CircuitCo/BeagleBone-LCD4-RevA1/README

The BeagleBone LCD4 Cape provides a portable LCD solution with touchscreen capability for BeagleBone boards. The 4.3" TFT LCD screen, attached to the topside of the board, can display up to a resolution of 480x272 and is a 4-wire resistive touchscreen. The board is equipped with seven buttons located at finger-friendly positions. These buttons include power, reset, and five user buttons, which are mapped to different GPIO signals. The backside of the cape is where a BeagleBone can be mounted.
