CircuitCo/BeagleBone-LCD4-RevA1/BeagleBone-LCD4-RevA1-bom.xls

BeagleBone LCD4 Cape COVER PAGE Revised: Wednsday, November 28, 2012
BB-BONE-LCD4-01 Revision: A1
ITM | QTY | REF DESIGNATIORS | PART | Foot Print | DESCRIPTION | MAN | PART # | COMMENT
1 | 1 | PCB |  |  |  |  | BB-BONE-LCD4-PCB-02
 | 20 | C1,C2,C3,C4,C5,C6,C7,C8,C9,C10,C11,C12,C13,C14,C15,C16,C17,C18,C19,C23 | 0.1uF | 402 | Capacitor 0.1uF 16V 10% 0402 X7R | Kemet | C0402C104K4RACT
2 | 2 | C20,C21 | 10uF,10V | 805 | CAP CER 10UF 10V Y5V 0805 | TDK | C2012Y5V1A106Z
3 | 2 | C38,C40 | 4.7uF, 25V | c805-35x60 | CAP CER 4.7UF 50V X5R 10% 0805 |  | C2012X5R1H475K
4 | 1 | C39 | 47nF | c402-25 | CAP CER 0.047UF 25V X5R 0402 |  | TMK105B7473KV-F
5 | 2 | D4,D5 | LTST-C190GKT | led2-31sq | LED GREEN CLEAR 0603 SMD |  | LTST-C190GKT
6 | 1 | L2 | 4.7uH | ind-lqh32m | INDUCTOR 4.7UH 20% 450MA 1210 |  | LQH32CN4R7M23L
7 | 2 | P1,P2 | MALE HEADER 2x23 | HEADER23X2 |  | MLE | BSTS-123-D-A-16-F-300-LF
8 | 1 | P5 |  | CON40SMD_P5MMLS_HRS_FH19SC | CONN FPC/FFC 40POS .5MM SMD GOLD | HIROSE | FH19C-40S-0.5SH(05)
9 | 1 | Q1 | DMC56404 | SMini6-F3-B | TRANS PREBIASED DUAL NPN SOT363 |  | DDC114YU-7-F
10 | 1 | Q3 | BSS138 | SOT23-3 | MOSFET Nchan 50V 200mA | Diodes Inc. | BSS138-7-F
11 | 2 | R3,R4 | 5.6K | 402 | RES 5.6K OHM 1/16W 5% 0402 SMD | Yaego | RC0402JR-075K6L
12 | 3 | R5,R6,R7 | 4.75K | 402 | RES 4.75K OHM 1/16W 1% 0402 SMD | Stackpole Electronics | RMCF0402FT4K75
13 | 10 | R8,R92,R98,R100,R113,R114,R115,R117,R118,R139 | 10K | 402 | Resistor 10Kohm 1/16W 5% 0402 | Rohm | MCR01MZPJ103
14 | 42 | R9,R10,R11,R12,R13,R14,R15,R16,R17,R18,R19,R20,R21,R22,R23,R24,R25,R26,R27,R28,R29,R30,R31,R32,R33,R34,R35,R36,R37,R38,R39,R40,R41,R42,R43,R44,R45,R46,R47,R48,R49,R50, | 33 | 402 | RES 33.0 OHM 1/16W 1% 0402 SMD | Yaego | RC0402FR-0733RL
15 | 8 | R70,R72,R73,R74,R75,R76,R77,R78 | 1k | 402 | RES 1K OHM 1/16W 1% 0402 SMD | Stackpole Electronics | RMCF0402FT1K00
16 | 2 | R97,R137 | 470 | r402-25 | Resistor 470ohm 1/16W 5% 0402 |  | ERJ-2GEJ471X
17 | 9 | R99,R111,R112,R102,R104,R106,R108,R122,R123 | 0 | 402 | RES 0.0 OHM 1/16W 0402 SMD |  | RMCF0402ZT0R00
18 | 2 | R116,R136 | 100K,1% | SM-7351-RES-0402 | RES 100K OHM 1/16W 5% 0402 SMD |  | RMCF0402JT100K
19 | 1 | R119 | 10R | c402-25 | RES 10.0 OHM 1/16W 1% 0402 SMD | Yaego | RC0402FR-0710RL
20 | 1 | R121 | 12K | c402-25 | RES 12K OHM 1/16W 1% 0402 SMD |  | ERJ-2RKF1202X
21 | 1 | R127 | 2E | 603 | RES 2.00 OHM 1/10W 1% 0603 SMD | Yaego | RC0603FR-072RL
22 | 4 | R130,R131,R133,R135 | 0 | 603 | RES 0.0 OHM 1/10W 0603 SMD | Yaego | RC0603JR-070RL
23 | 1 | SW1 | SW DIP-2 | swdip4_100-339smd | SWITCH TAPE SEAL 2 POS SMD | CTS | 219-2MST
24 | 1 | S1 | B3U-1100 | SW3_4X2P5 | SWITCH TACTILE SPST-NO 0.05A 12V |  | B3U-1100P
25 | 5 | S2,S3,S4,S5,S6 | B3F-1000 | SWRST4_177X256LS-1 | SWITCH TACTILE SPST-NO 0.05A 24V | Omron | B3F-1000
26 | 1 | S7 | B3F-3100 | sw4-b3f-315x | SWITCH TACTILE SPST-NO 0.05A 24V, RA | Omron | B3F-3100
27 | 1 | U1 | CAT24C256W | SOIC_8 | IC EEPROM 256KBIT 400KHZ 8SOIC | ON | CAT24C256WI-G
28 | 1 | U2 | 74avc32t245 | BGA96-ZKE | IC BUS TRANSCVR 32BIT 96BGA | TI | SN74AVC32T245ZKER
29 | 1 | U6 | SN74LVC1G06DCK | DCK5 | IC INVERTER SINGLE 1INPUT SC705 | TI | SN74LVC1G06DCKR
30 | 1 | U5 | TPS61080DRC | drc10-11x33 | IC REG LDO CAP FREE 8-SON | TI | TPS61080DRC
31 | 1 | LCD4 |  |  |  |  | NHD-4.3-480272MF-ATXI-T-1
32 | DNI | C22,D1,L1,L3,J1,J2,P3,P4,R1,R2,R101,R103,R105,R107,R109,R110,R120,R124,R125,R126,R128,R129,R132,R134,TP1,TP2,TP3,U3,U4,R51,R52,R53,R54,R55,R56,R57,R58,R59,R60,R61,R62,R63,R64,R65,R66,R67,R68,R69,R71,R79,R80,R81,R82,R83,R84,R85,R86,R87,R88,R89,R90,R91,R93,R94,R95,R96
