CircuitCo/BeagleBone-LCD4-RevA1/BeagleBone-LCD4-RevA1-schematic.pdf

01-MAY-2012 | BBT

# DATE

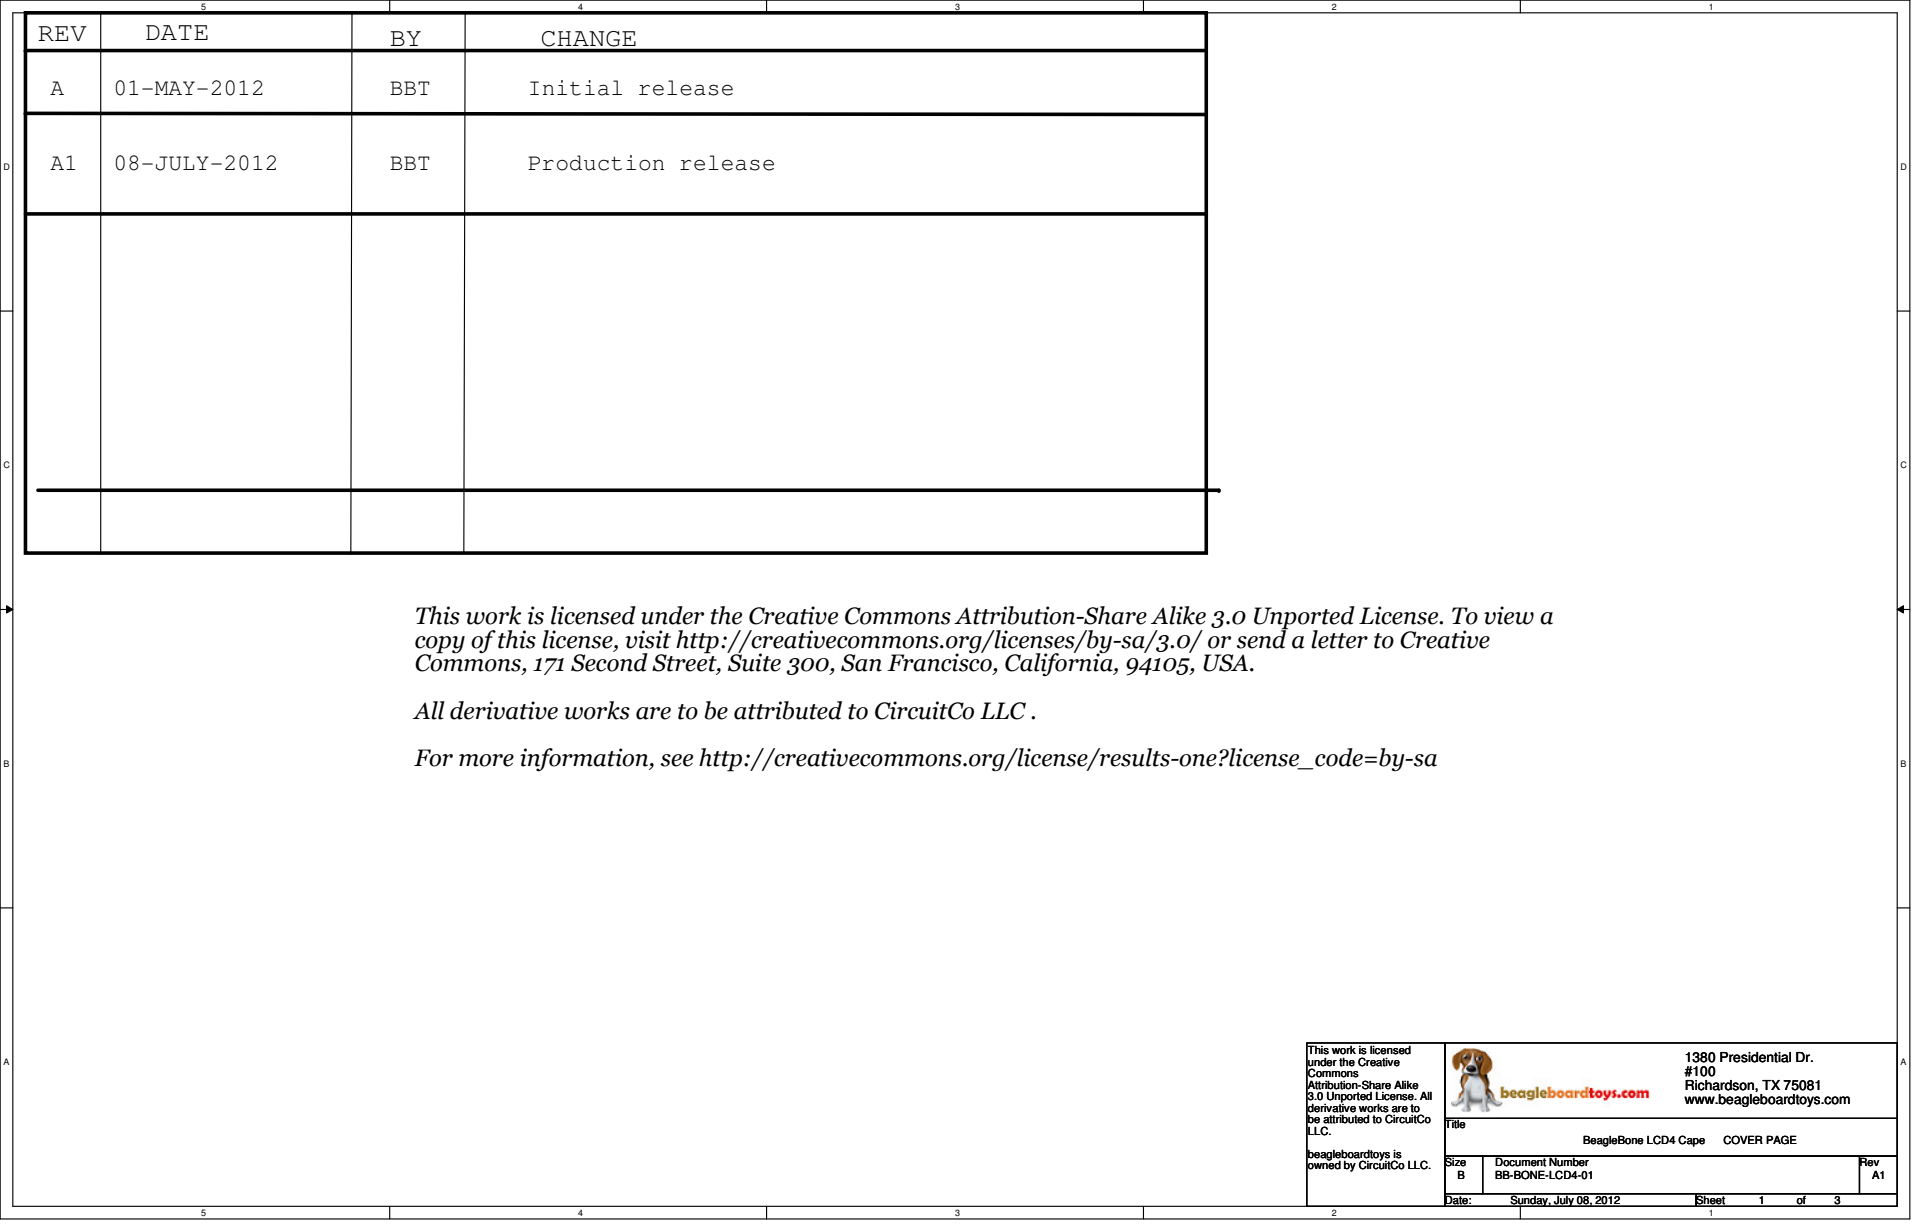
[picture p1: page 1]
REV; CHANGE; Initial release; 08-JULY-2012; BBT; Production release; Title; Size; Document Number; Rev; Date:; Sheet; BB-BONE-LCD4-01; BeagleBone LCD4 Cape; COVER PAGE; Sunday, July 08, 2012

This work is licensed under the Creative Commons Attribution-Share Alike 3.0 Unported License. To view a
copy of this license, visit http://creativecommons.org/licenses/by-sa/3.0/ or send a letter to Creative
Commons, 171 Second Street, Suite 300, San Francisco, California, 94105, USA.

All derivative works are to be attributed to CircuitCo LLC .

For more information, see http://creativecommons.org/license/results-one?license_code=by-sa

This work is licensed
under the Creative
Commons
Attribution-Share Alike
3.0 Unported License. All
derivative works are to
be attributed to CircuitCo
LLC.

1380 Presidential Dr.
Richardson, TX 75081
www.beagleboardtoys.com

beagleboardtoys is
owned by CircuitCo LLC.

## SYS_nRESET GPIO1_28

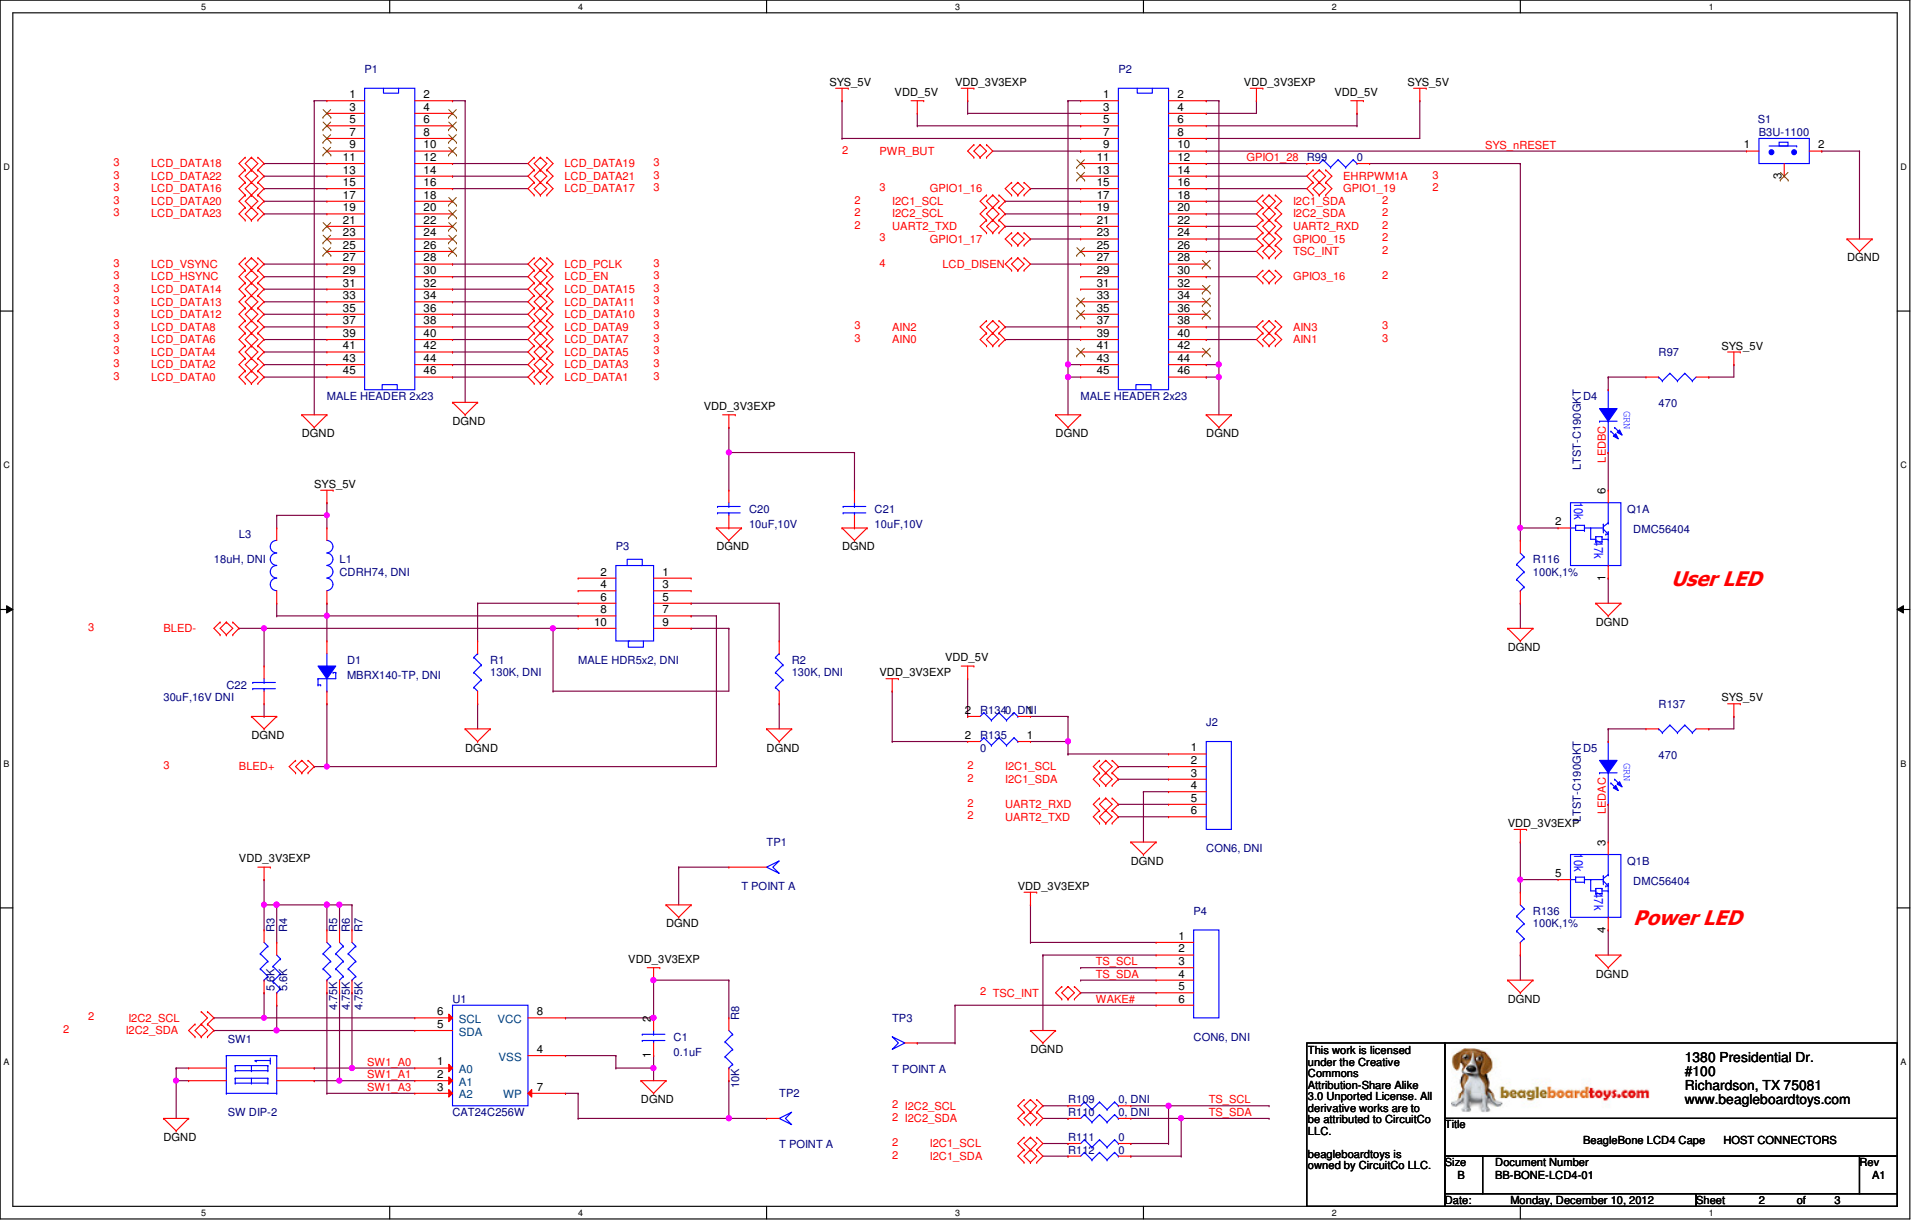
[picture p2: page 2]
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

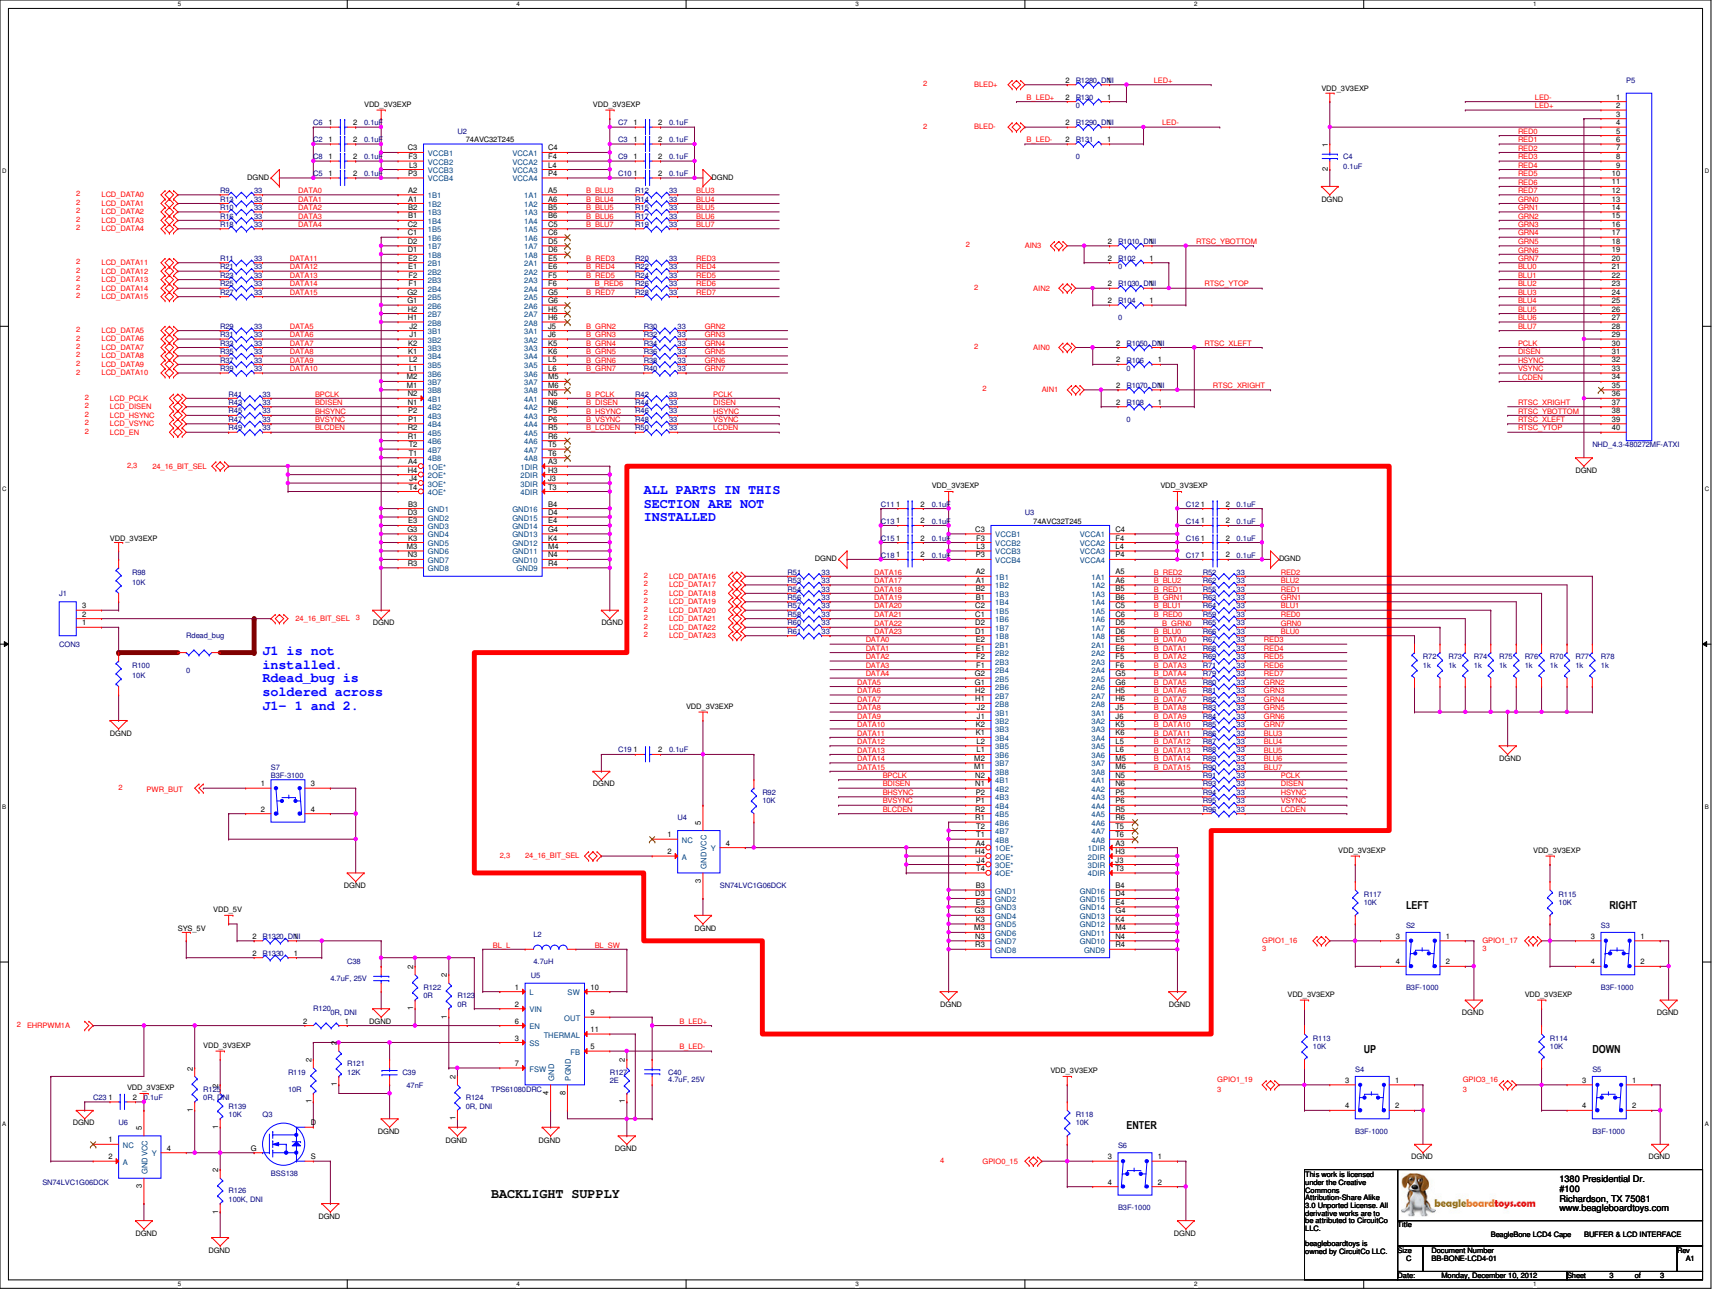
[picture p3: page 3]

ALL PARTS IN THIS
SECTION ARE NOT
INSTALLED

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
