CircuitCo/BeagleBone-LCD4-RevA1/(list of files, drawings)

Other design files:
BeagleBone-LCD4-RevA1-schematic.dsn
